mochoy/arduino-clone/README.md

# arduino-clone
Eagle schematic and board files for custom Arduino clones
