mochoy/arduino-clone/arduino clone v0.1/arduino clone schematics.pdf

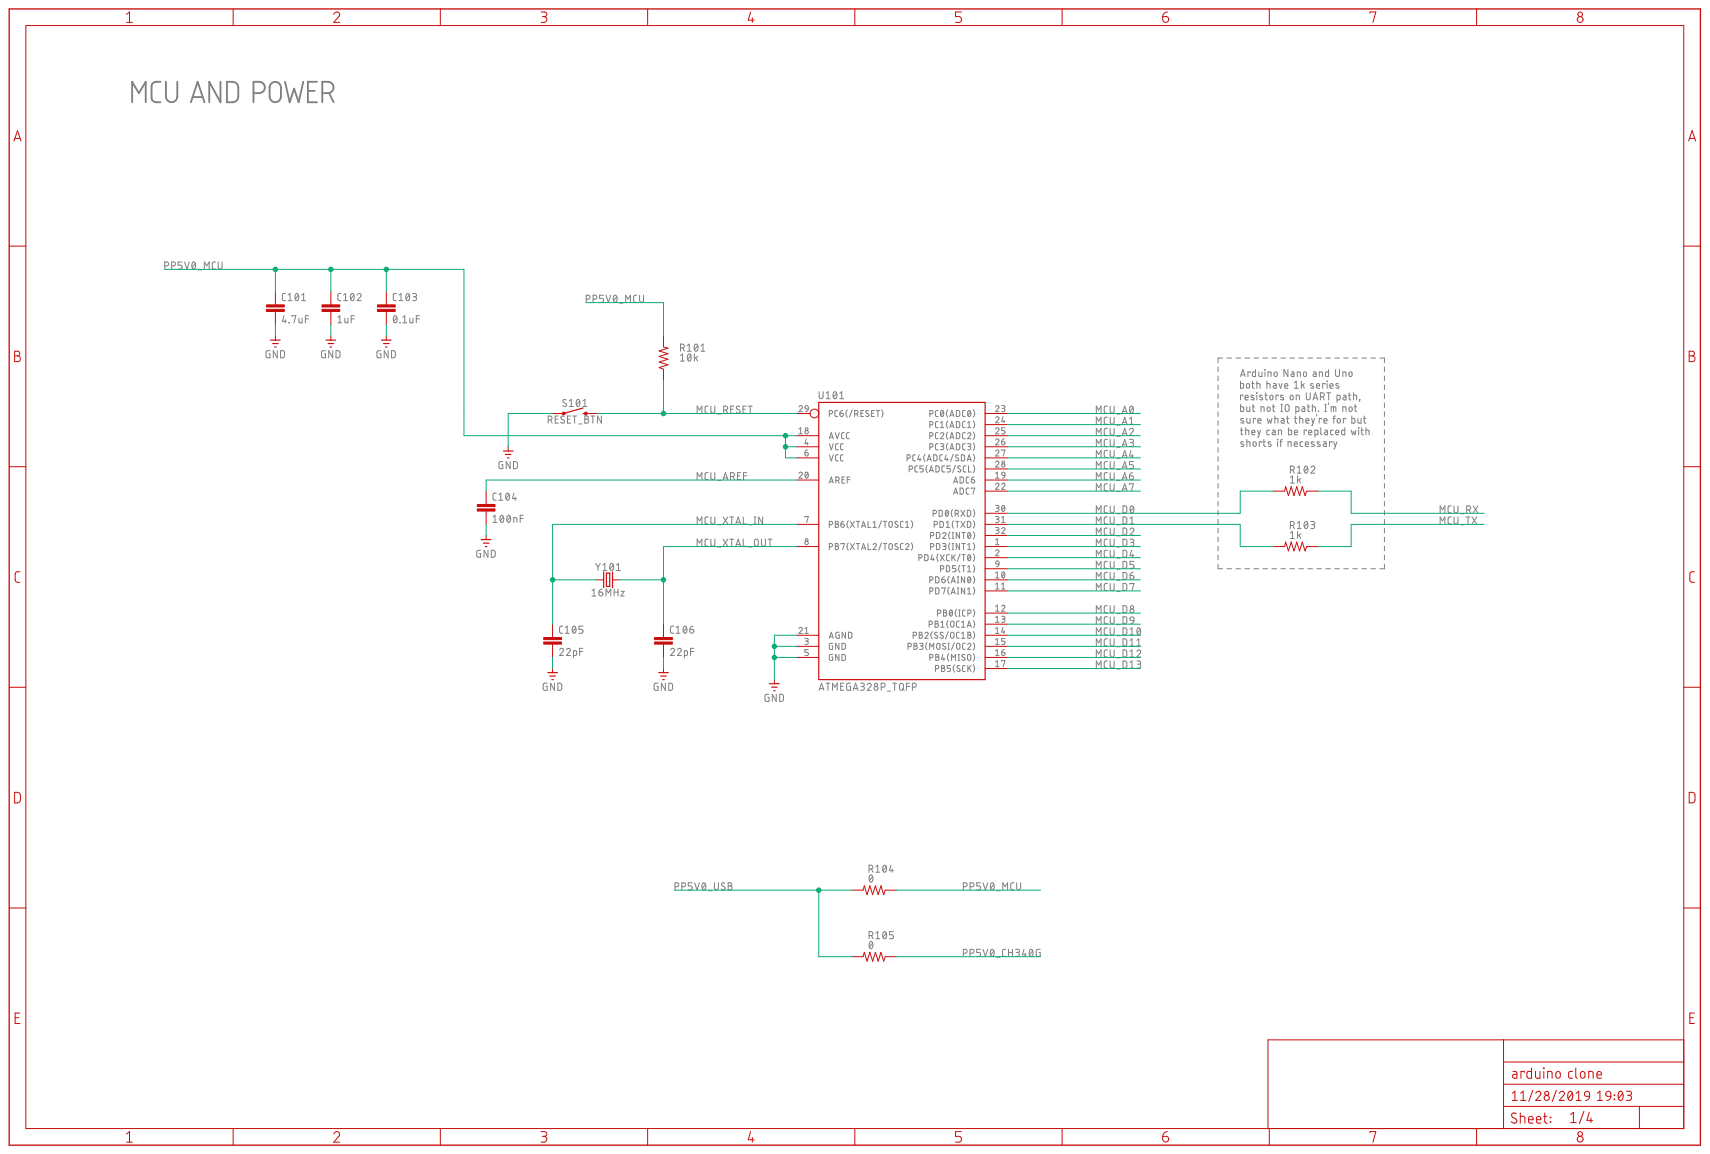
[picture p1: page 1]

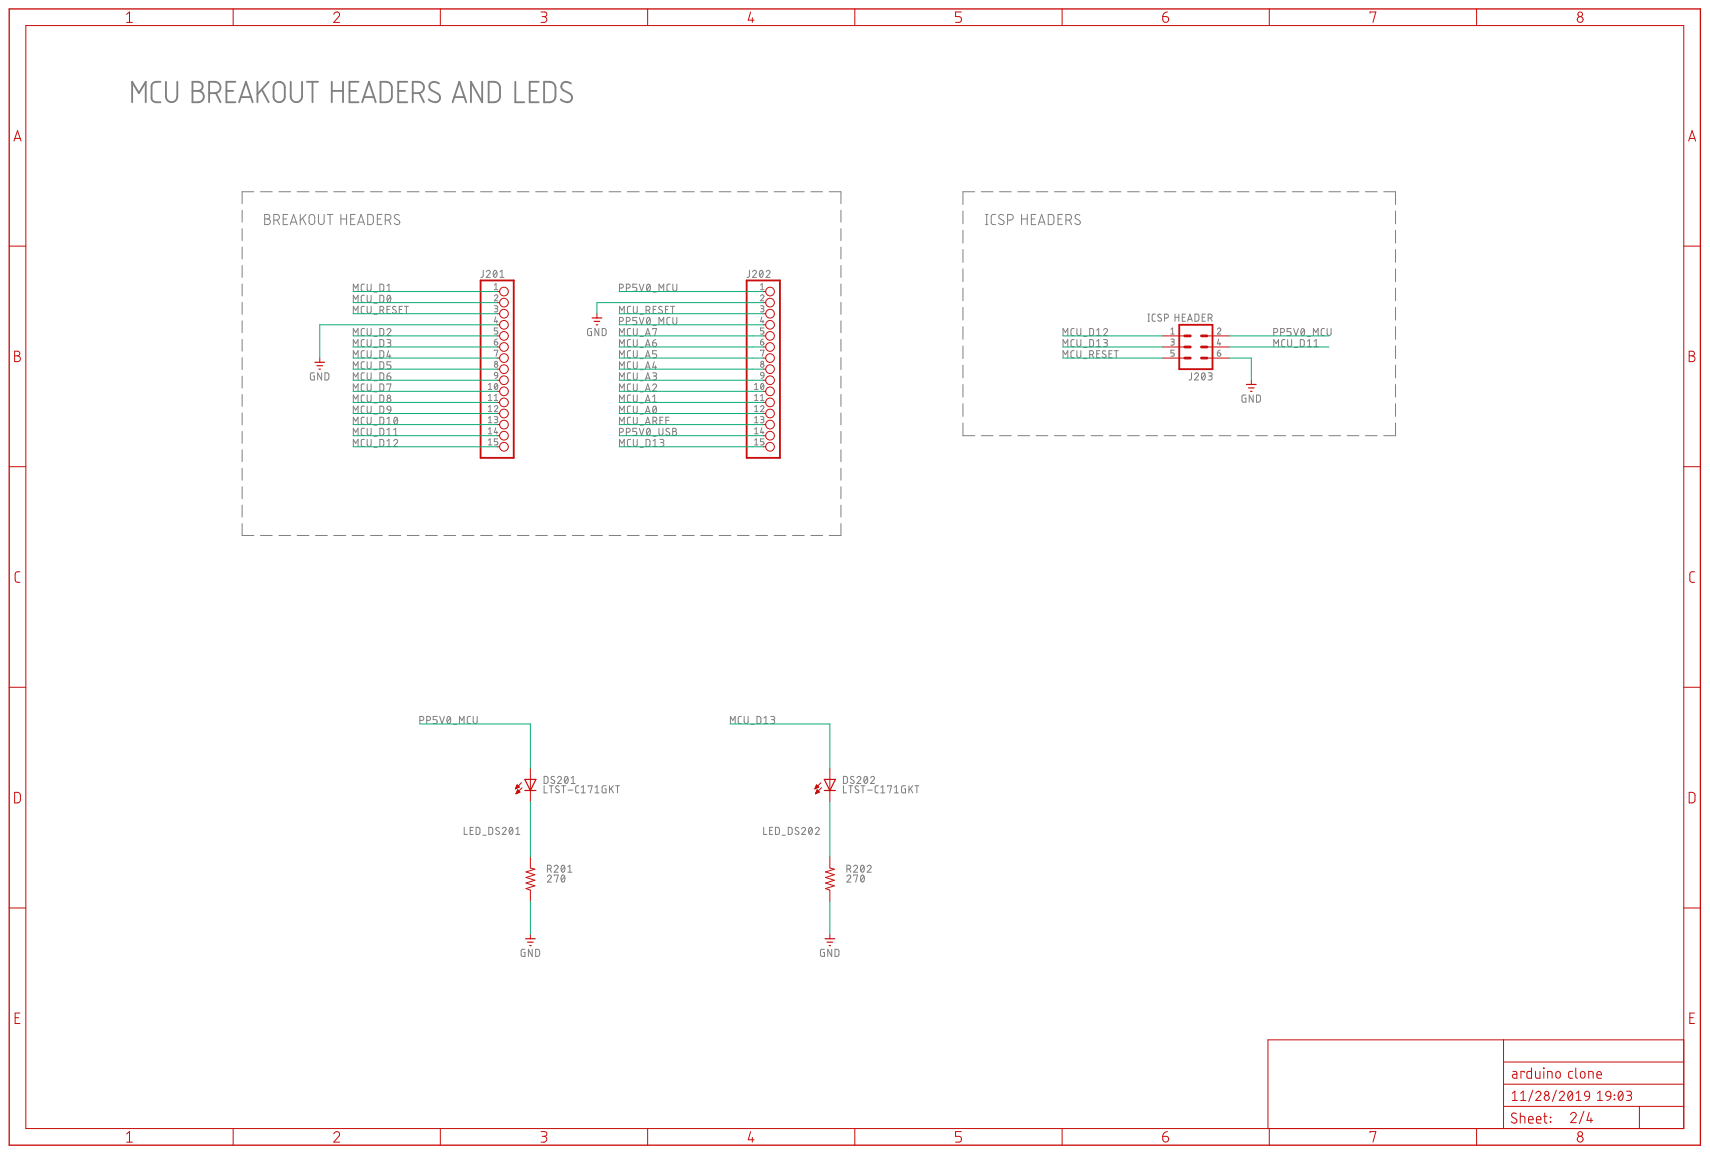
[picture p2: page 2]

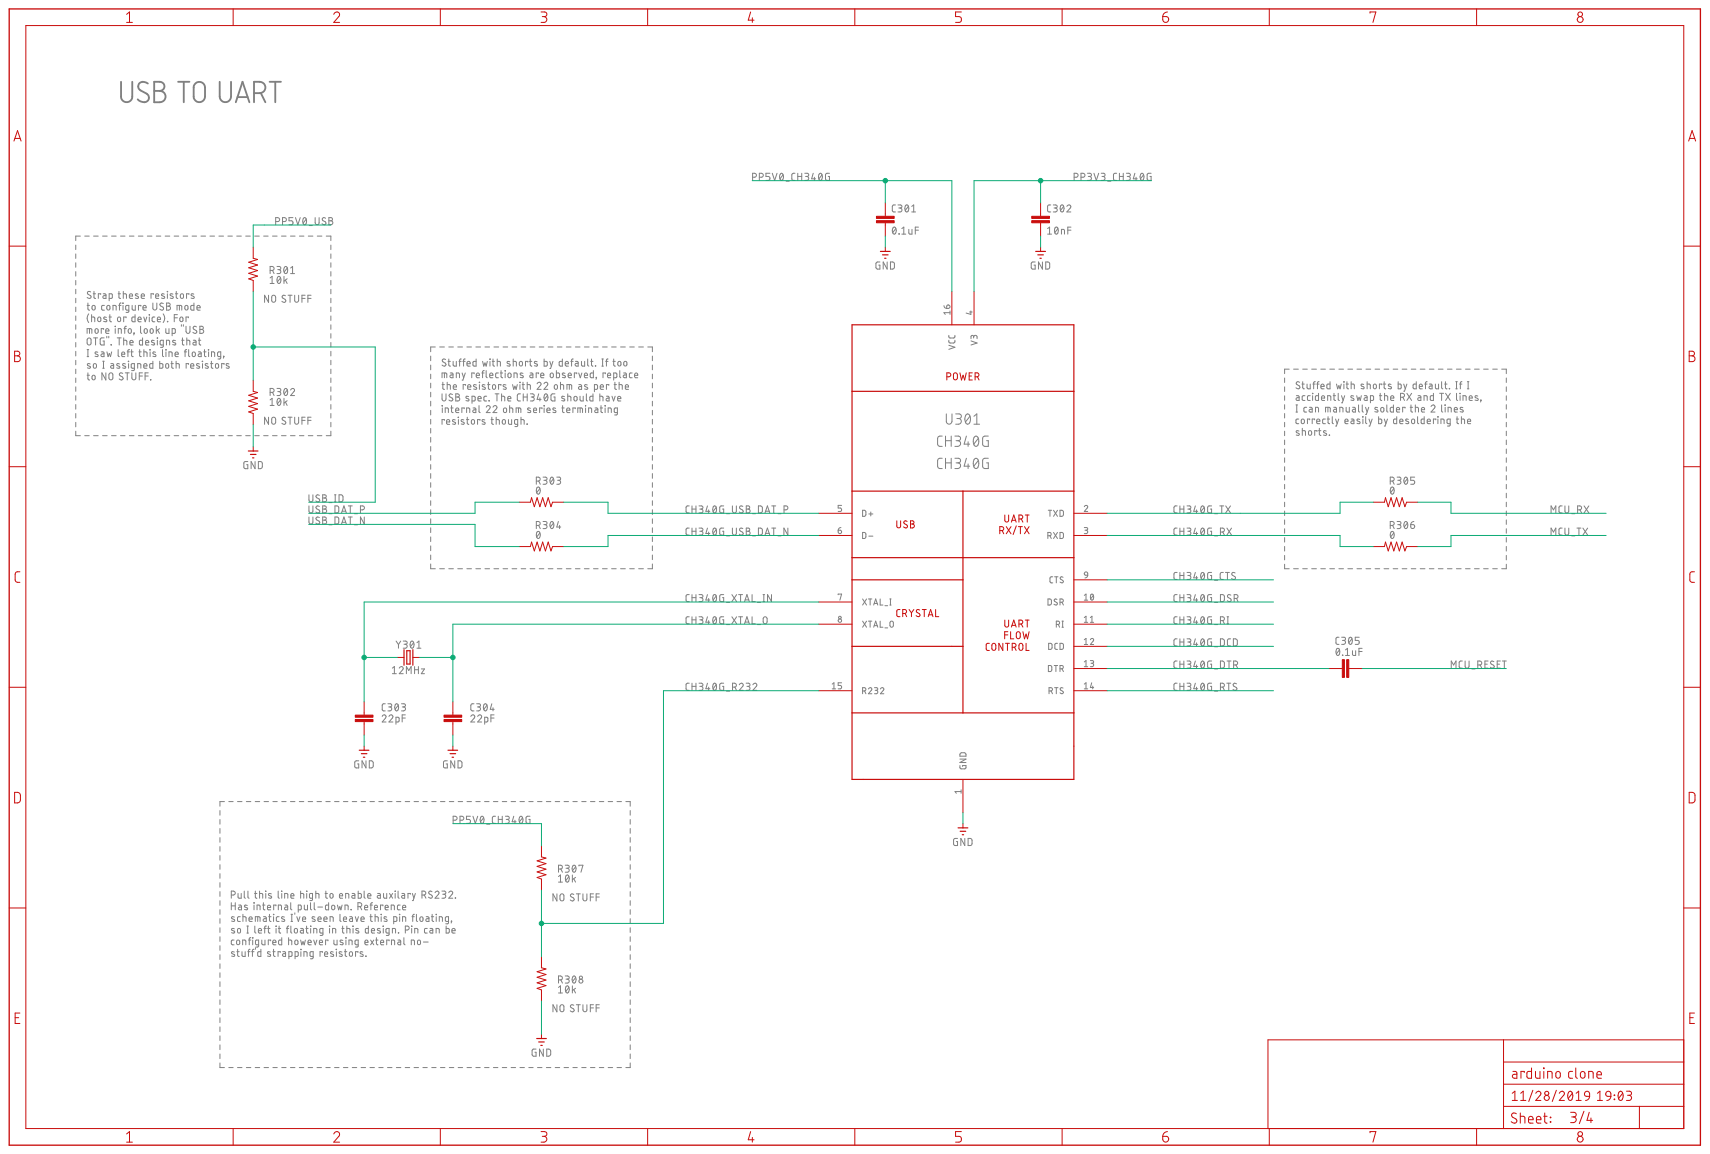
[picture p3: page 3]

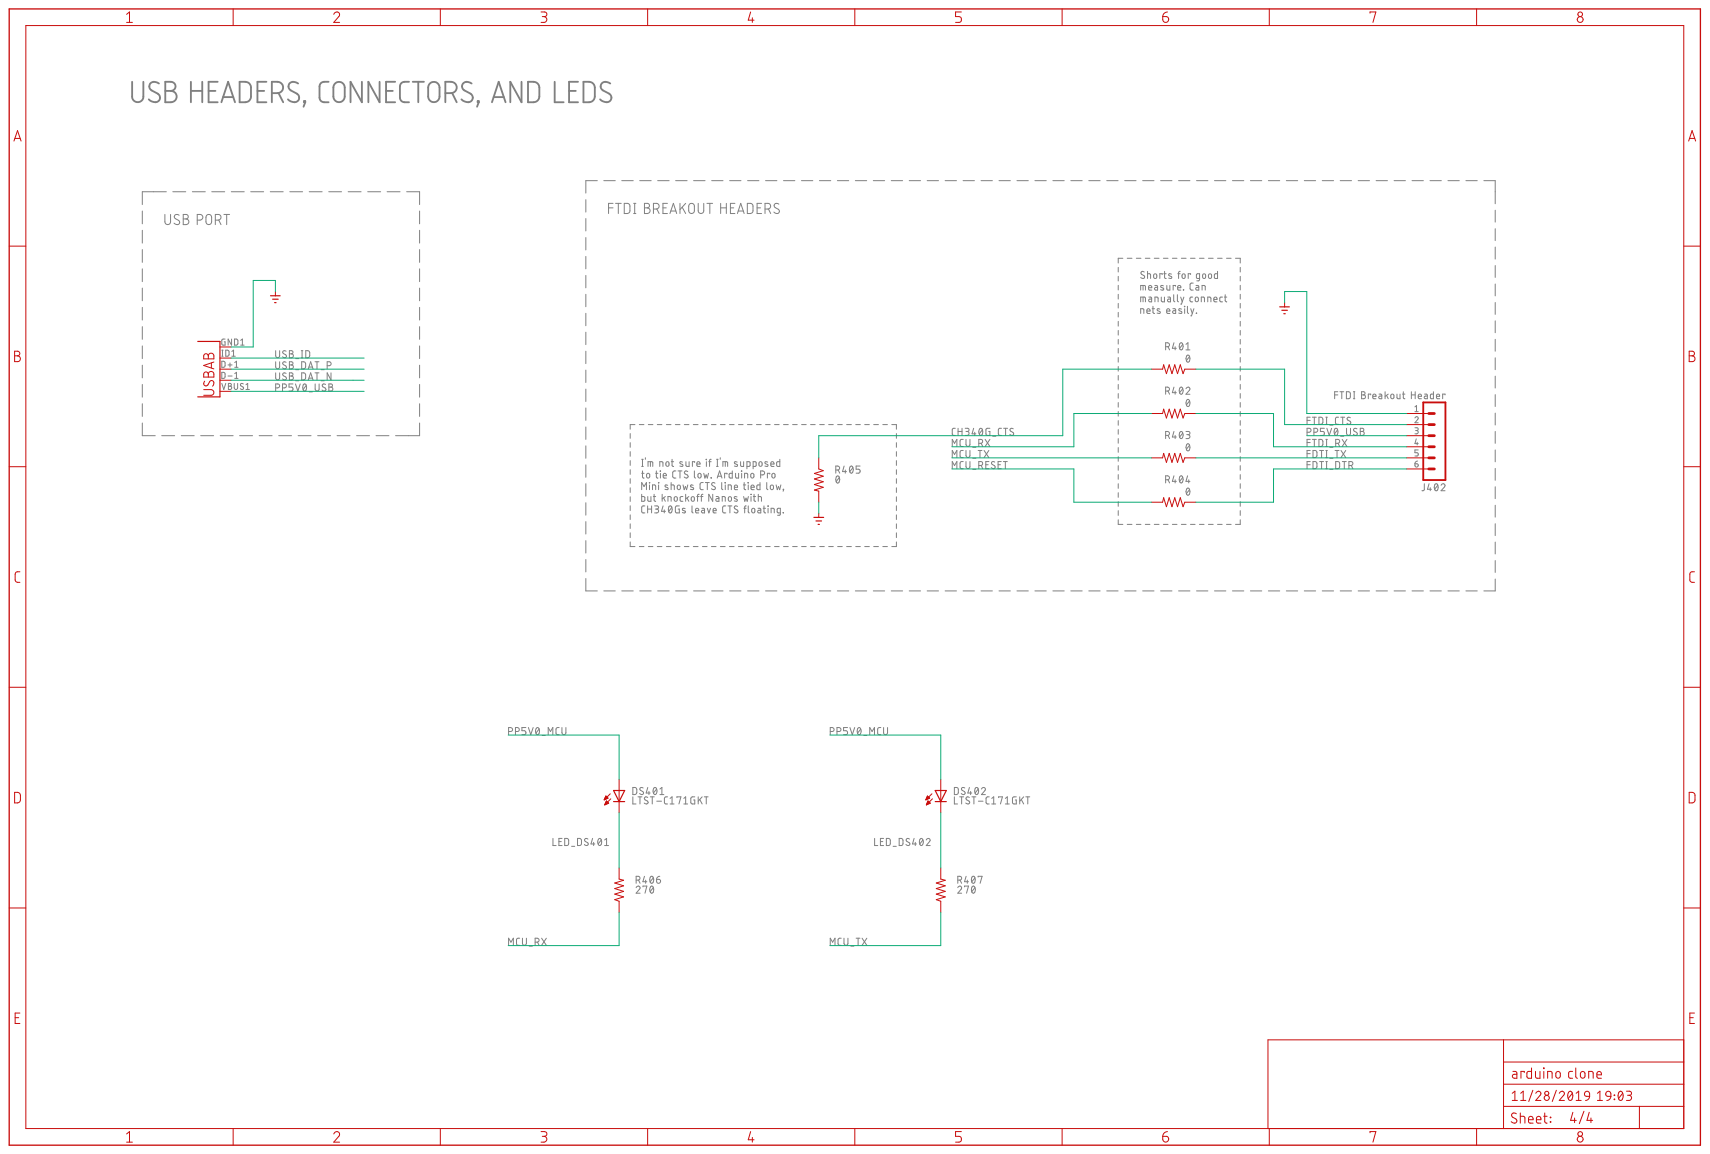
[picture p4: page 4]
