mochoy/arduino-clone/arduino clone v0.1/arduino clone.brd

## EAGLE design arduino clone v0.1/arduino clone.brd (2020-04-21)

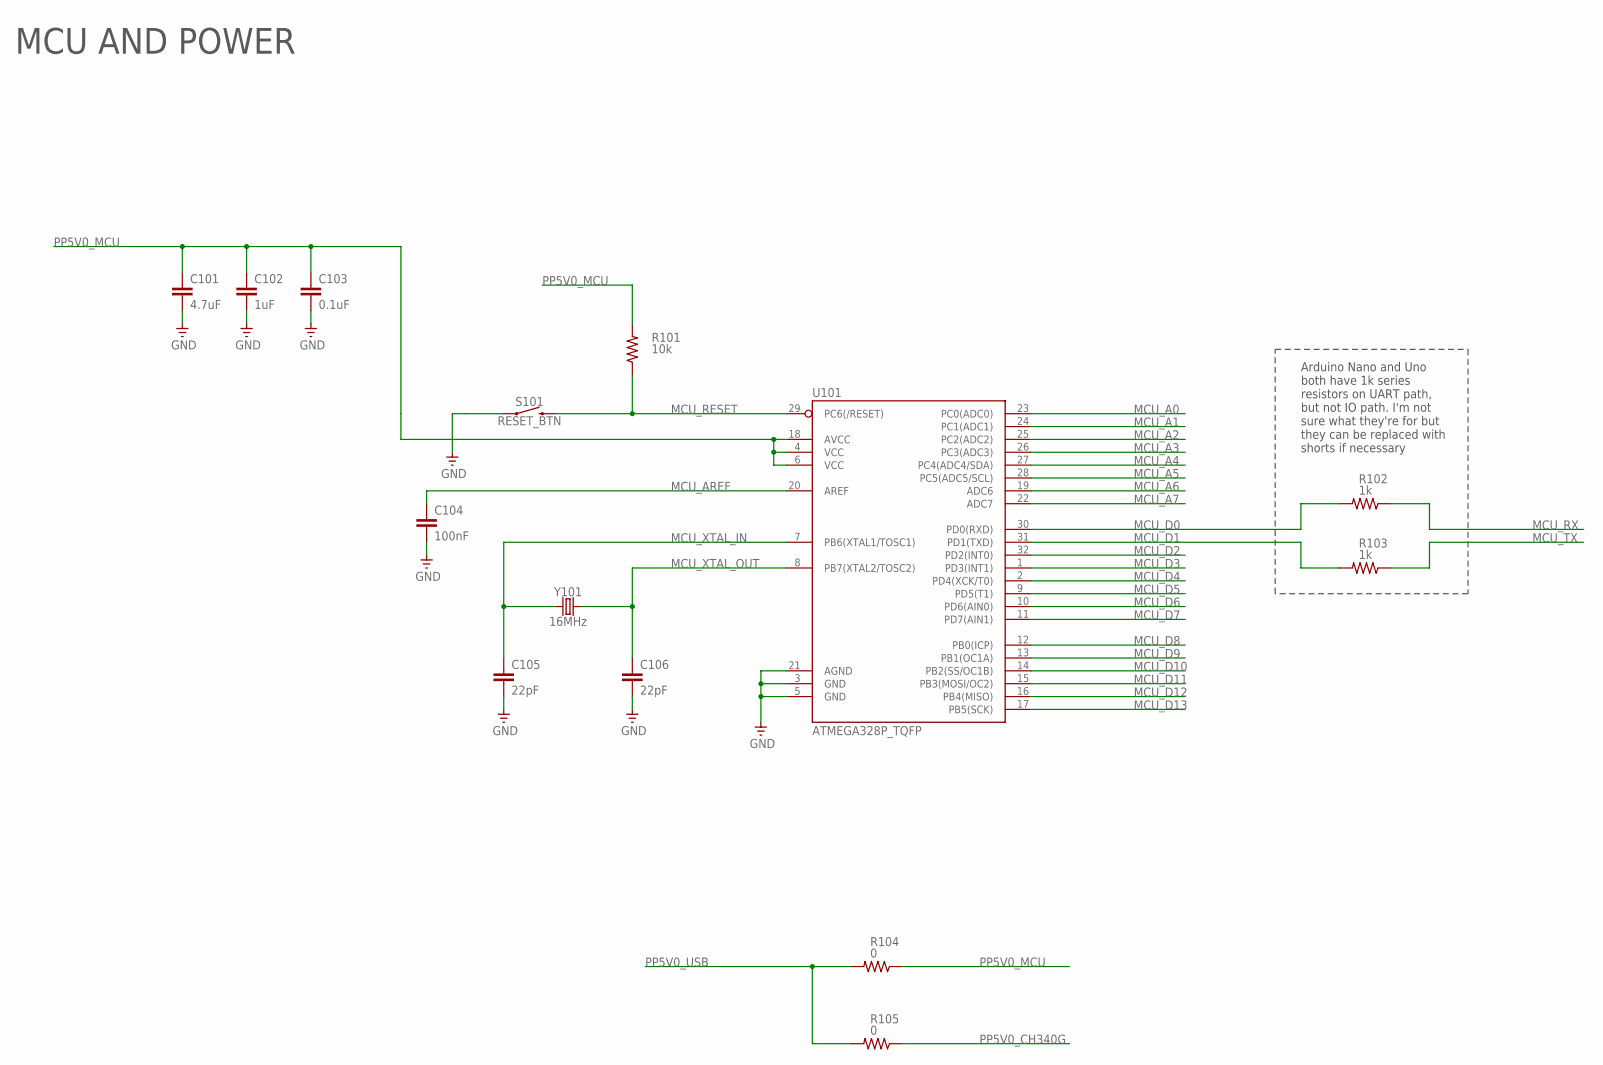
[picture p5: schematic arduino clone.sch, sheet 1]

Parts:
C101: 4.7uF; C0805
C102: 1uF; C0805
C103: 0.1uF; C0805
C104: 100nF; C0805
C105, C106: 22pF; C0805
R101: 10k; R0805
R102, R103: 1k; R0805
R104, R105: 0; R0805
S101: RESET_BTN; TACTILE_SWITCH_SMD_6.2MM_TALL
U101: ATMEGA328P_TQFP; TQFP32-08
Y101: 16MHz; CRYSTAL-SMD-5X3.2-4PAD

Connections:
GND: C101.2, C102.2, C103.2, C104.2, C105.2, C106.2, S101.A2 (1), U101.3 (GND), U101.5 (GND), U101.21 (AGND); also elsewhere on the board
MCU_A0: U101.23 (PC0(ADC0)); also elsewhere on the board
MCU_A1: U101.24 (PC1(ADC1)); also elsewhere on the board
MCU_A2: U101.25 (PC2(ADC2)); also elsewhere on the board
MCU_A3: U101.26 (PC3(ADC3)); also elsewhere on the board
MCU_A4: U101.27 (PC4(ADC4/SDA)); also elsewhere on the board
MCU_A5: U101.28 (PC5(ADC5/SCL)); also elsewhere on the board
MCU_A6: U101.19 (ADC6); also elsewhere on the board
MCU_A7: U101.22 (ADC7); also elsewhere on the board
MCU_AREF: C104.1, U101.20 (AREF); also elsewhere on the board
MCU_D0: R102.2, U101.30 (PD0(RXD)); also elsewhere on the board
MCU_D1: R103.2, U101.31 (PD1(TXD)); also elsewhere on the board
MCU_D2: U101.32 (PD2(INT0)); also elsewhere on the board
MCU_D3: U101.1 (PD3(INT1)); also elsewhere on the board
MCU_D4: U101.2 (PD4(XCK/T0)); also elsewhere on the board
MCU_D5: U101.9 (PD5(T1)); also elsewhere on the board
MCU_D6: U101.10 (PD6(AIN0)); also elsewhere on the board
MCU_D7: U101.11 (PD7(AIN1)); also elsewhere on the board
MCU_D8: U101.12 (PB0(ICP)); also elsewhere on the board
MCU_D9: U101.13 (PB1(OC1A)); also elsewhere on the board
MCU_D10: U101.14 (PB2(SS/OC1B)); also elsewhere on the board
MCU_D11: U101.15 (PB3(MOSI/OC2)); also elsewhere on the board
MCU_D12: U101.16 (PB4(MISO)); also elsewhere on the board
MCU_D13: U101.17 (PB5(SCK)); also elsewhere on the board
MCU_RESET: R101.1, S101.B2 (2), U101.29 (PC6(/RESET)); also elsewhere on the board
MCU_RX: R102.1; also elsewhere on the board
MCU_TX: R103.1; also elsewhere on the board
MCU_XTAL_IN: C105.1, U101.7 (PB6(XTAL1/TOSC1)), Y101.1
MCU_XTAL_OUT: C106.1, U101.8 (PB7(XTAL2/TOSC2)), Y101.3 (2)
PP5V0_CH340G: R105.1; also elsewhere on the board
PP5V0_MCU: C101.1, C102.1, C103.1, R101.2, R104.1, U101.4 (VCC), U101.6 (VCC), U101.18 (AVCC); also elsewhere on the board
PP5V0_USB: R104.2, R105.2; also elsewhere on the board

Notes on the sheet:
MCU AND POWER
Arduino Nano and Uno both have 1k series resistors on UART path, but not IO path. I'm not sure what they're for but they can be replaced with shorts if necessary

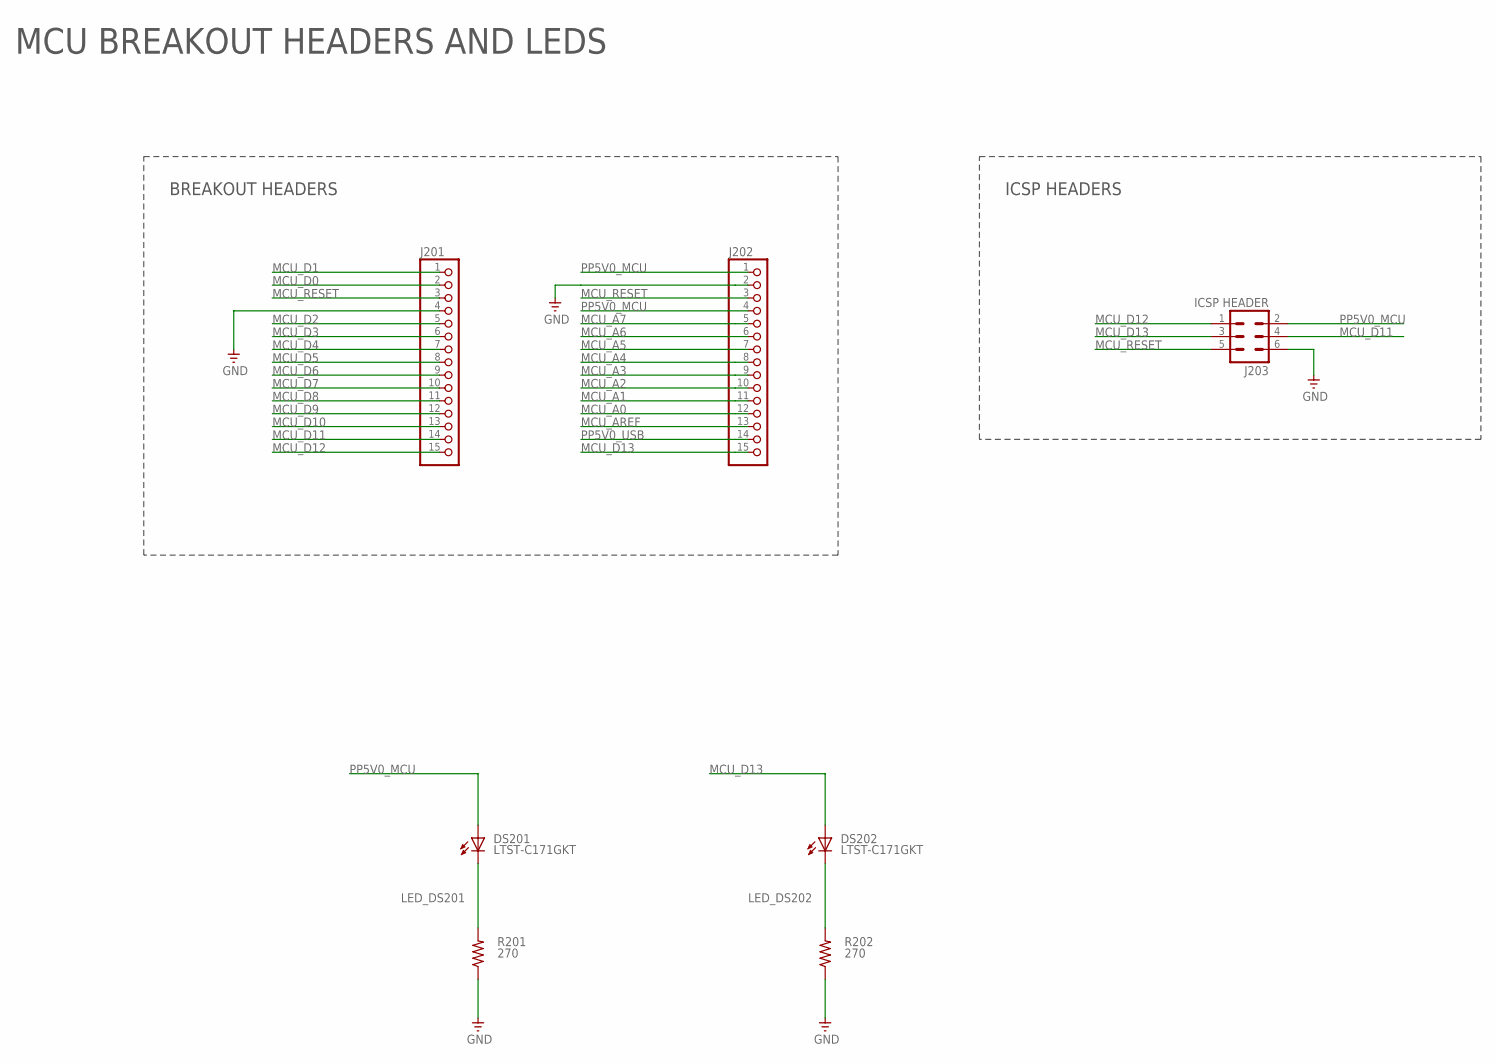
[picture p6: schematic arduino clone.sch, sheet 2]

Parts:
DS201, DS202: LTST-C171GKT; CHIPLED_0805
J201, J202: PINHD-1X15-CB; 1X15-CB
J203: ICSP HEADER; MA03-2
R201, R202: 270; M0805

Connections:
GND: J201.4, J202.2, J203.6, R201.1, R202.1; also elsewhere on the board
LED_DS201: DS201.C, R201.2
LED_DS202: DS202.C, R202.2
MCU_A0: J202.12; also elsewhere on the board
MCU_A1: J202.11; also elsewhere on the board
MCU_A2: J202.10; also elsewhere on the board
MCU_A3: J202.9; also elsewhere on the board
MCU_A4: J202.8; also elsewhere on the board
MCU_A5: J202.7; also elsewhere on the board
MCU_A6: J202.6; also elsewhere on the board
MCU_A7: J202.5; also elsewhere on the board
MCU_AREF: J202.13; also elsewhere on the board
MCU_D0: J201.2; also elsewhere on the board
MCU_D1: J201.1; also elsewhere on the board
MCU_D2: J201.5; also elsewhere on the board
MCU_D3: J201.6; also elsewhere on the board
MCU_D4: J201.7; also elsewhere on the board
MCU_D5: J201.8; also elsewhere on the board
MCU_D6: J201.9; also elsewhere on the board
MCU_D7: J201.10; also elsewhere on the board
MCU_D8: J201.11; also elsewhere on the board
MCU_D9: J201.12; also elsewhere on the board
MCU_D10: J201.13; also elsewhere on the board
MCU_D11: J201.14, J203.4; also elsewhere on the board
MCU_D12: J201.15, J203.1; also elsewhere on the board
MCU_D13: DS202.A, J202.15, J203.3; also elsewhere on the board
MCU_RESET: J201.3, J202.3, J203.5; also elsewhere on the board
PP5V0_MCU: DS201.A, J202.1, J202.4, J203.2; also elsewhere on the board
PP5V0_USB: J202.14; also elsewhere on the board

Notes on the sheet:
MCU BREAKOUT HEADERS AND LEDS
BREAKOUT HEADERS
ICSP HEADERS

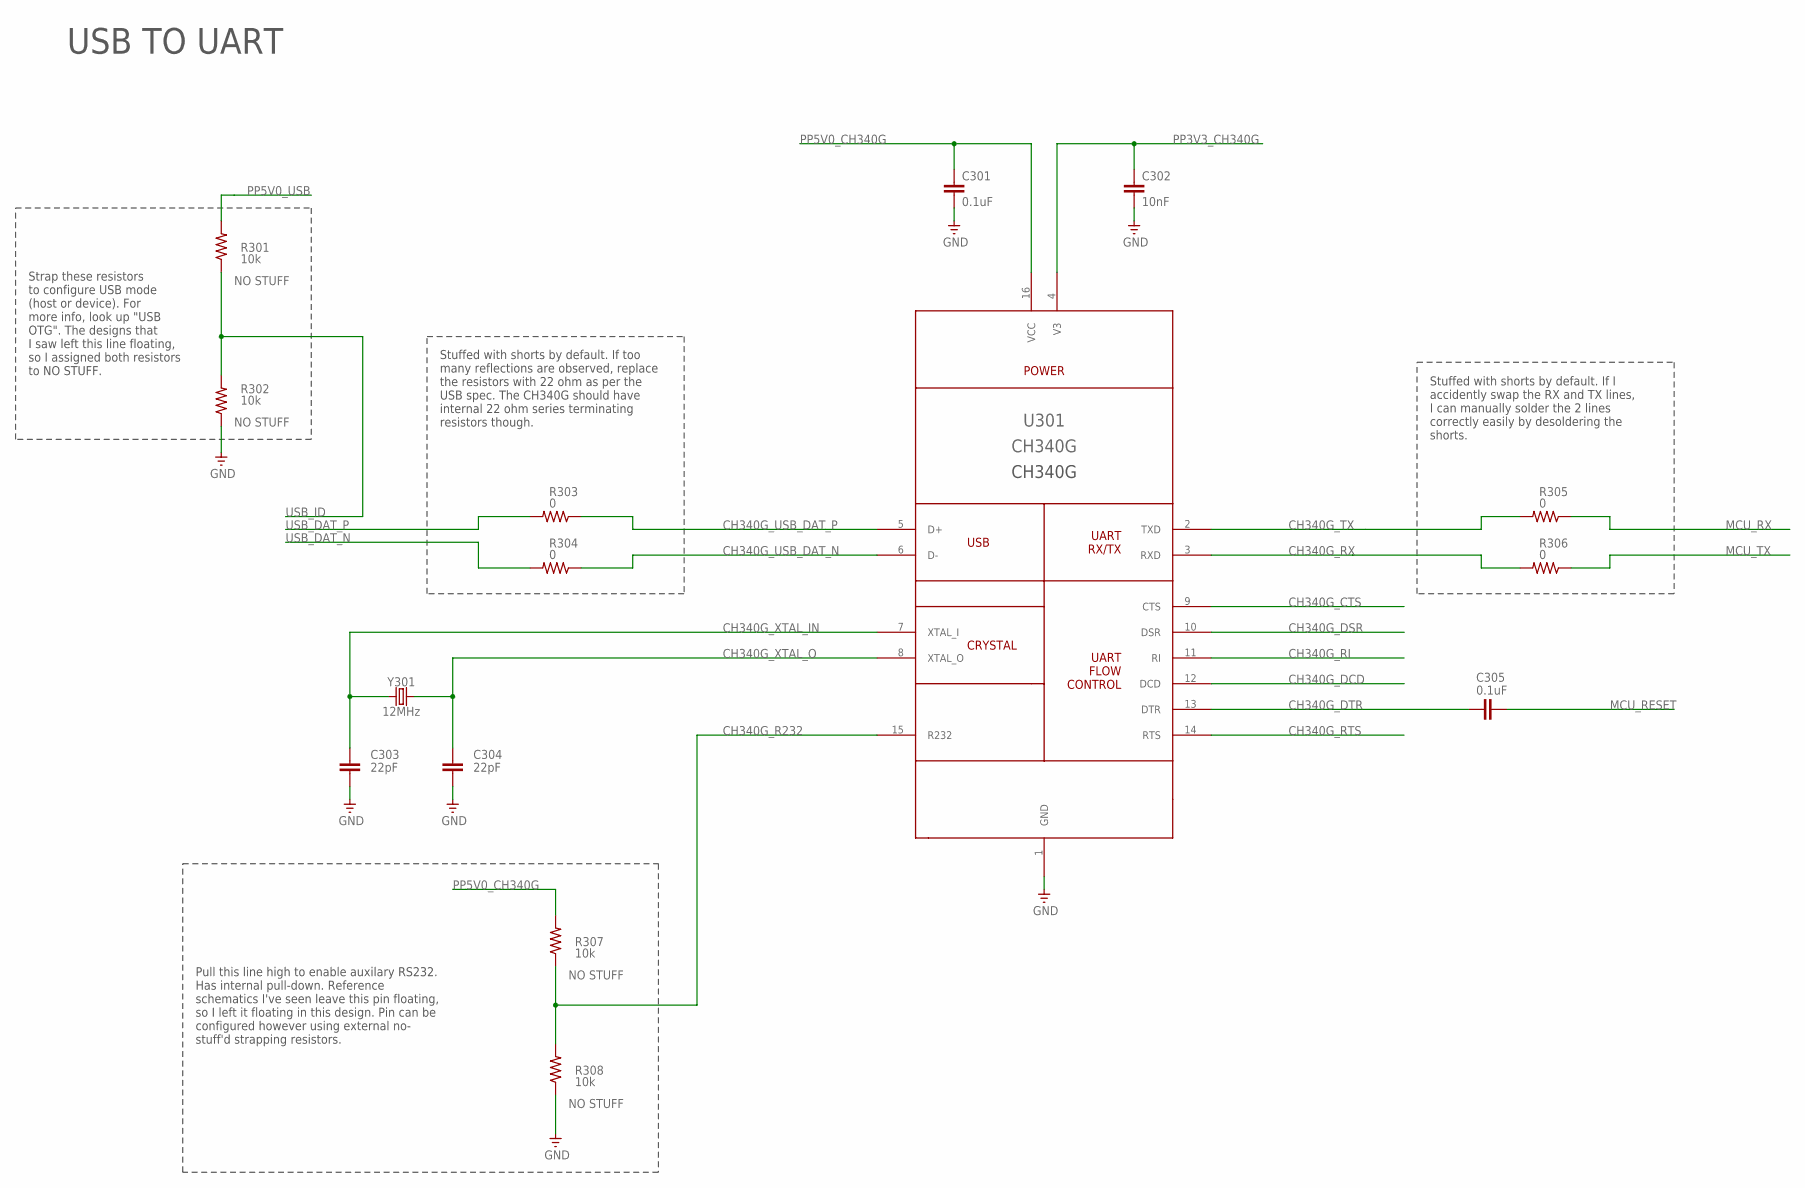
[picture p7: schematic arduino clone.sch, sheet 3]

Parts:
C301, C305: 0.1uF; C0805
C302: 10nF; C0805
C303, C304: 22pF; C0805
R301, R302, R307, R308: 10k; R0805
R303, R304, R305, R306: 0; R0805
U301: CH340G; SOIC16
Y301: 12MHz; CRYSTAL-SMD-5X3.2-4PAD

Connections:
CH340G_CTS: U301.9 (CTS); also elsewhere on the board
CH340G_DCD: U301.12 (DCD)
CH340G_DSR: U301.10 (DSR)
CH340G_DTR: C305.1, U301.13 (DTR)
CH340G_R232: R307.1, R308.2, U301.15 (R232)
CH340G_RI: U301.11 (RI)
CH340G_RTS: U301.14 (RTS)
CH340G_RX: R306.2, U301.3 (RXD)
CH340G_TX: R305.2, U301.2 (TXD)
CH340G_USB_DAT_N: R304.1, U301.6 (D-)
CH340G_USB_DAT_P: R303.1, U301.5 (D+)
CH340G_XTAL_IN: C303.1, U301.7 (XTAL_I), Y301.1
CH340G_XTAL_O: C304.1, U301.8 (XTAL_O), Y301.3 (2)
GND: C301.2, C302.2, C303.2, C304.2, R302.1, R308.1, U301.1 (GND); also elsewhere on the board
MCU_RESET: C305.2; also elsewhere on the board
MCU_RX: R305.1; also elsewhere on the board
MCU_TX: R306.1; also elsewhere on the board
PP3V3_CH340G: C302.1, U301.4 (V3)
PP5V0_CH340G: C301.1, R307.2, U301.16 (VCC); also elsewhere on the board
PP5V0_USB: R301.2; also elsewhere on the board
USB_DAT_N: R304.2; also elsewhere on the board
USB_DAT_P: R303.2; also elsewhere on the board
USB_ID: R301.1, R302.2; also elsewhere on the board

Notes on the sheet:
USB TO UART
Strap these resistors to configure USB mode (host or device). For more info, look up "USB OTG". The designs that I saw left this line floating, so I assigned both resistors to NO STUFF.
Stuffed with shorts by default. If too many reflections are observed, replace the resistors with 22 ohm as per the USB spec. The CH340G should have internal 22 ohm series terminating resistors though.
Stuffed with shorts by default. If I accidently swap the RX and TX lines, I can manually solder the 2 lines correctly easily by desoldering the shorts.
Pull this line high to enable auxilary RS232. Has internal pull-down. Reference schematics I've seen leave this pin floating, so I left it floating in this design. Pin can be configured however using external no- stuff'd strapping resistors.

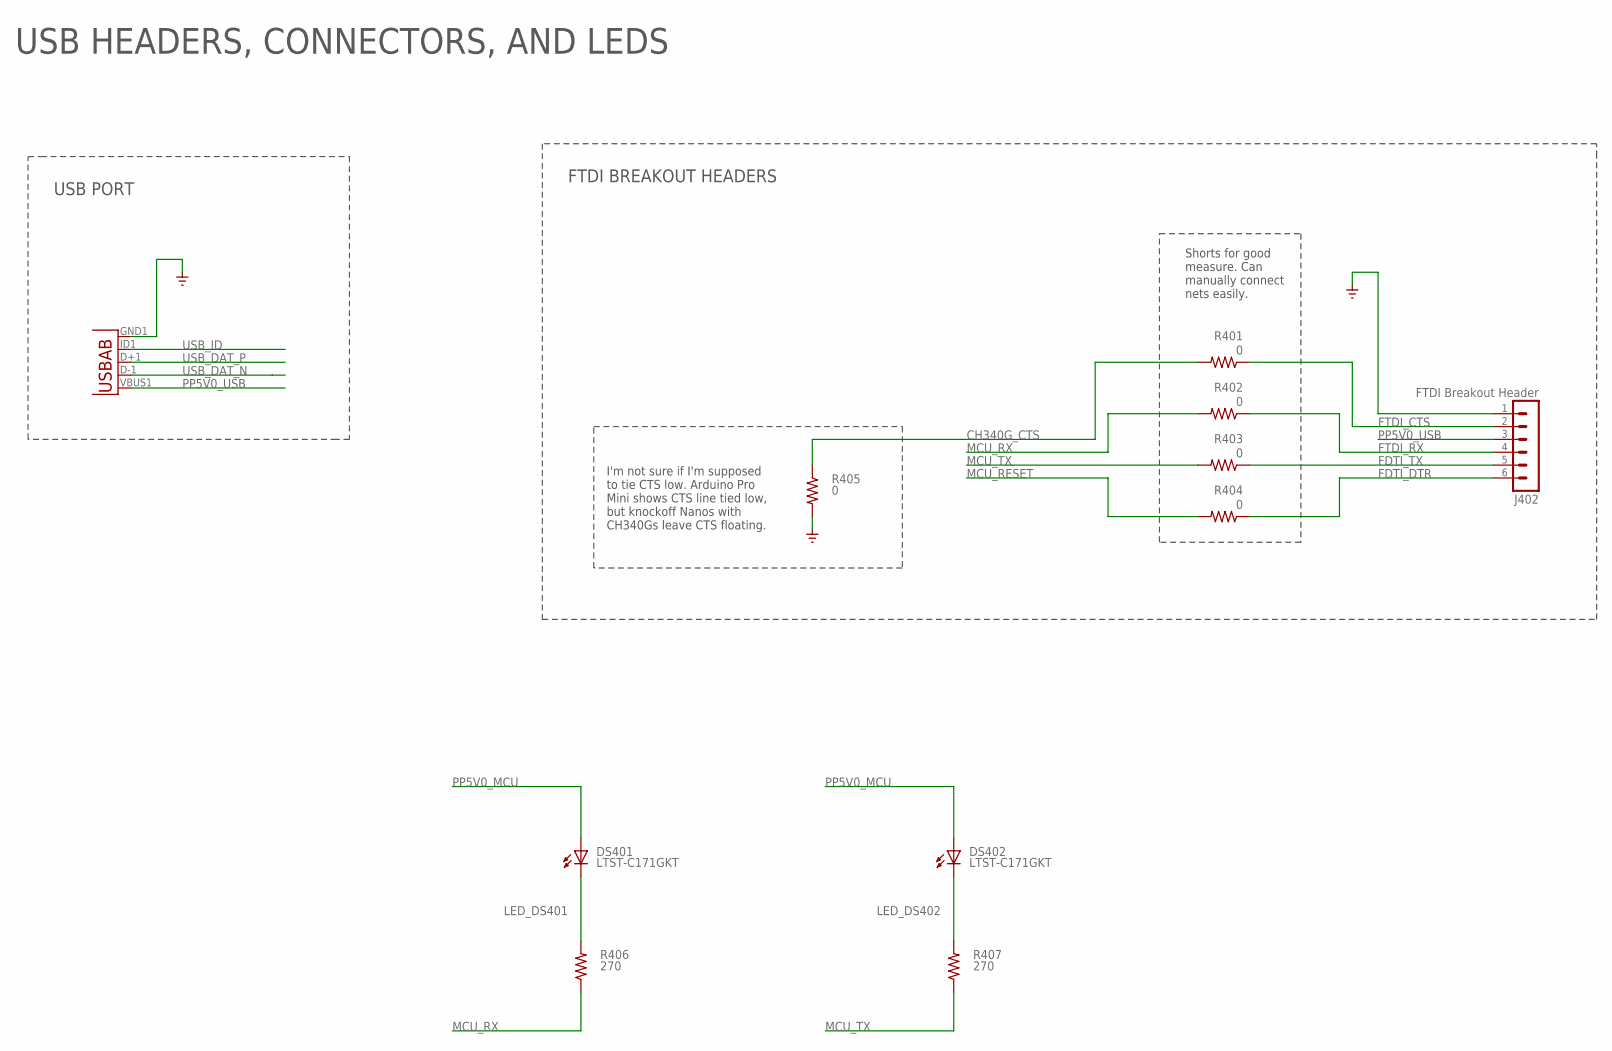
[picture p8: schematic arduino clone.sch, sheet 4]

Parts:
DS401, DS402: LTST-C171GKT; CHIPLED_0805
J401: USB-ABIN&OUT; USB-AB-MICRO-SMD-V03-IN&OUT
J402: FTDI Breakout Header; MA06-1
R401, R402, R403, R404, R405: 0; R0805
R406, R407: 270; M0805

Connections:
CH340G_CTS: R401.2, R405.1; also elsewhere on the board
FDTI_DTR: J402.6, R404.1
FDTI_TX: J402.5, R403.1
FTDI_CTS: J402.2, R401.1
FTDI_RX: J402.4, R402.1
GND: J401.GND1 (GND), J402.1, R405.2; also elsewhere on the board
LED_DS401: DS401.C, R406.2
LED_DS402: DS402.C, R407.2
MCU_RESET: R404.2; also elsewhere on the board
MCU_RX: R402.2, R406.1; also elsewhere on the board
MCU_TX: R403.2, R407.1; also elsewhere on the board
PP5V0_MCU: DS401.A, DS402.A; also elsewhere on the board
PP5V0_USB: J401.VBUS1 (VBUS), J402.3; also elsewhere on the board
USB_DAT_N: J401.D-1 (D-); also elsewhere on the board
USB_DAT_P: J401.D+1 (D+); also elsewhere on the board
USB_ID: J401.ID1 (USBID); also elsewhere on the board

Notes on the sheet:
USB HEADERS, CONNECTORS, AND LEDS
Shorts for good measure. Can manually connect nets easily.
I'm not sure if I'm supposed to tie CTS low. Arduino Pro Mini shows CTS line tied low, but knockoff Nanos with CH340Gs leave CTS floating.
USB PORT
FTDI BREAKOUT HEADERS

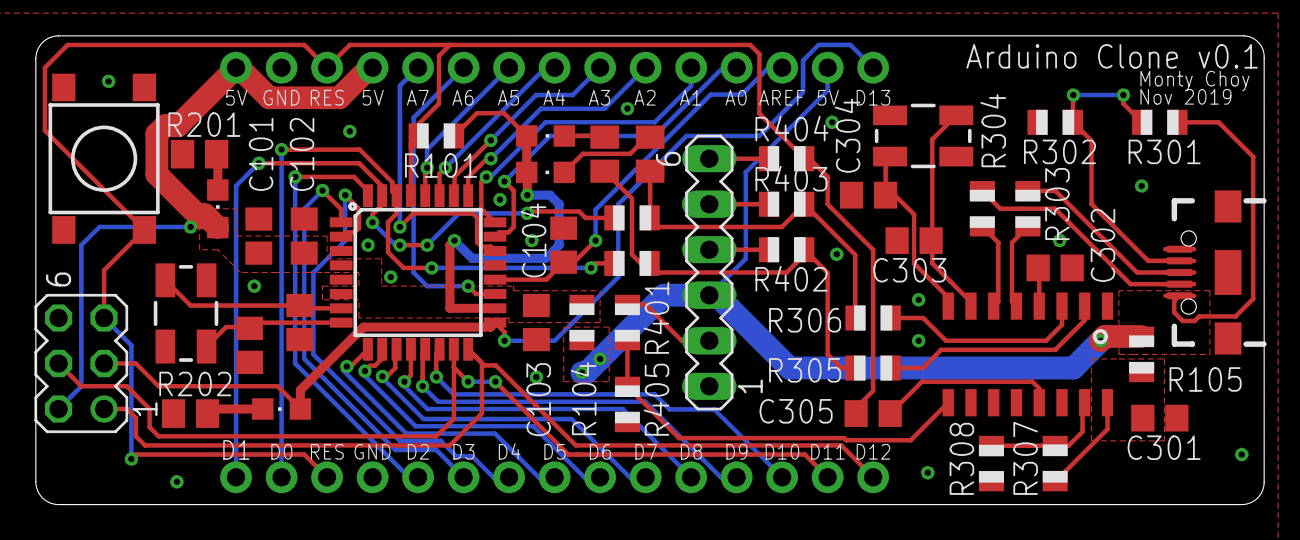
[picture p9: board arduino clone.brd from above]

Board: 2 copper layers, 68.6 x 26.2 mm, 47 parts (0 on the bottom side), 53 nets.
