mochoy/arduino-clone/(commit log)

2019-11-11 create project for arduino clone v0.1
2019-11-11 create schematic file for arduino clone
    [arduino clone.sch]
2019-11-11 add pages for MCU and CH340G
    [arduino clone.sch]
2019-11-12 add atmega328p and CH340G ICs
    [arduino clone.sch]
2019-11-12 add title to MCU and USB to UART pages
    [arduino clone.sch]
2019-11-14 connect VCC of MCU to PP5V0 rail
    [arduino clone.sch]
2019-11-15 connect gnd rails of MCU
    [arduino clone.sch]
2019-11-16 add decoupling caps to Arduino VCC rail
    [arduino clone.sch]
2019-11-16 add pullup to MCU reset
    [arduino clone.sch]
2019-11-16 add cap to aref pin
    [arduino clone.sch]
2019-11-16 add reset btn:
    [arduino clone.sch]
2019-11-18 add custom CH340G symbol
    [arduino clone.sch]
2019-11-18 add rail and rename CH340G
    [arduino clone.sch]
2019-11-19 add decoupling cap to 5V rail of CH340G
    [arduino clone.sch]
2019-11-19 connect gnd potential to CH340G
    [arduino clone.sch]
2019-11-19 add decoupling cap to PP3V3_CH340G rail
    [arduino clone.sch]
2019-11-19 add sparkfun micro USB port
    [arduino clone.sch]
2019-11-19 swap out USB for one used in Arduino Sparkfun pro mini
    [arduino clone.sch]
2019-11-19 connect gnd to usb port
    [arduino clone.sch]
2019-11-19 connect diff pair for USB
    [arduino clone.sch]
2019-11-19 add strapping resistors to ID of USB hub
    [arduino clone.sch]
2019-11-19 move strapping resistor ref des and value
    [arduino clone.sch]
2019-11-19 add power rail for USB
    [arduino clone.sch]
2019-11-19 add net name for USB ID pin
    [arduino clone.sch]
2019-11-19 add series termniation resistors for USB data diff pair
    [arduino clone.sch]
2019-11-19 add net names for diff pair on USB side
    [arduino clone.sch]
2019-11-19 add names for diff pair on CH340G side
    [arduino clone.sch]
2019-11-20 remove extra net on PP_USB rail
    [arduino clone.sch]
2019-11-20 add nostuff attribute to USB_ID net
    [arduino clone.sch]
2019-11-20 add descriptiont to strap USB_ID resistors
    [arduino clone.sch]
2019-11-20 move USB port and USB OTG strapping resistors
    [arduino clone.sch]
2019-11-21 add box around series termination resistors
    [arduino clone.sch]
2019-11-21 add note for series terminating resistors
    [arduino clone.sch]
2019-11-21 add RX and TX lines from CH340G
    [arduino clone.sch]
2019-11-21 add series resistors to UART lines
    [arduino clone.sch]
2019-11-21 add net names for AR UART lines on CH340G page
    [arduino clone.sch]
2019-11-21 connect AR_RX and TX to arduino
    [arduino clone.sch]
2019-11-22 add box around UART data resistors
    [arduino clone.sch]
2019-11-24 Add note for series resistors on RX and TX lines UART
    [arduino clone.sch]
2019-11-25 rename MCU nets to have 'mcu'
    [arduino clone.sch]
2019-11-25 add AC coupling cap on DTR line of CH340G
    [arduino clone.sch]
2019-11-25 disconnect USB nets from connector
    [arduino clone.sch]
2019-11-25 add signal nets to USB connector
    [arduino clone.sch]
2019-11-25 add named nets for CH350G UART flow control
    [arduino clone.sch]
2019-11-25 add FTDI breakout header
    [arduino clone.sch]
2019-11-25 add nets from FDTI headers to power and CTS
    [arduino clone.sch]
2019-11-25 add FTDI RX and TX lines
    [arduino clone.sch]
2019-11-25 add FTDI_DTR line
    [arduino clone.sch]
2019-11-25 connect MCU uart data lines to AR uart datalines
    [arduino clone.sch]
2019-11-25 add notes for FTDI breakout headers
    [arduino clone.sch]
2019-11-25 add note on CTS line
    [arduino clone.sch]
2019-11-25 update libs to fix R232 short pin
    [arduino clone.sch]
2019-11-25 add strapping resistors on CH340G_R323 pin
    [arduino clone.sch]
2019-11-25 ad notes to R232 strapping resistors
    [arduino clone.sch]
2019-11-25 add 22 pf caps for pierce oscillator
    [arduino clone.sch]
2019-11-25 add nets for crystal
    [arduino clone.sch]
2019-11-25 add and name crystal oscillator
    [arduino clone.sch]
2019-11-25 move RS232 strappig network higher up
    [arduino clone.sch]
2019-11-25 replace crystal with 12MHz as per CH340G spec
    [arduino clone.sch]
2019-11-25 rename caps on 5V0 MCU rail to apple naming convention
    [arduino clone.sch]
2019-11-25 rename rest of MCU components to apple naming convnetnion:
    [arduino clone.sch]
2019-11-25 add back RS232 strapping network that I accidently deleted
    [arduino clone.sch]
2019-11-25 update library to have new XTAL pin names
    [arduino clone.sch]
2019-11-25 update oscillator net names to XTA
    [arduino clone.sch]
2019-11-25 add pierce oscillator to MCU
    [arduino clone.sch]
2019-11-25 add net names for MCU XTAL
    [arduino clone.sch]
2019-11-25 move MCU nets out to give space for net names
    [arduino clone.sch]
2019-11-25 move XTAL and AREF decoupling components out to give space for net names
    [arduino clone.sch]
2019-11-26 add MCU analog port nets
    [arduino clone.sch]
2019-11-26 add 1k resistors on MCU UART lines
    [arduino clone.sch]
2019-11-26 connect UART lines to MCU_[UART]_R
    [arduino clone.sch]
2019-11-26 diverge FTDI header nets
    [arduino clone.sch]
2019-11-26 re-arragne resistor and note for CH340G_CTS
    [arduino clone.sch]
2019-11-26 rotate ref des and value for CTS strapping resistor
    [arduino clone.sch]
2019-11-26 add notes on MCU UART lines
    [arduino clone.sch]
2019-11-26 rename MCU pins to MCU_Dx and MCU uart lines
    [arduino clone.sch]
2019-11-26 rename all MCU_TX_R to MCU_TX
    [arduino clone.sch]
2019-11-26 add nets for port D pins
    [arduino clone.sch]
2019-11-26 add nets for pins on port B
    [arduino clone.sch]
2019-11-26 change a decoupling cap on 5V_MCU rail to 0.1uF
    [arduino clone.sch]
2019-11-26 center MCU stuff on page
    [arduino clone.sch]
2019-11-26 add page for MCU Breakout headers
    [arduino clone.sch]
2019-11-26 add page for USB connectors, headers, and LEDs
    rename MCU headers page to also include LEDs
    [arduino clone.sch]
2019-11-26 move USB port to page 4
    [arduino clone.sch]
2019-11-26 move FTDI breakout header to page 3
    [arduino clone.sch]
2019-11-26 center CH340G on page
    [arduino clone.sch]
2019-11-26 Re-add netnames on page 4
    [arduino clone.sch]
2019-11-26 rename everything on page 3 to have '3' prefix
    [arduino clone.sch]
2019-11-26 add boxes and labels for USB port and FTDI breakout headers
    [arduino clone.sch]
2019-11-26 page 1 also dedicated to power
    [arduino clone.sch]
2019-11-26 move MCU stuff up to give space for power stuff below on same page
    [arduino clone.sch]
2019-11-26 add resistors for power stuff
    [arduino clone.sch]
2019-11-26 add ICSP header
    [arduino clone.sch]
2019-11-26 add breakout headers
    [arduino clone.sch]
2019-11-26 connect left breakout header
    [arduino clone.sch]
2019-11-26 connect breakout headers for right breakout headers
    [arduino clone.sch]
2019-11-26 add and label box around breakout headers
    [arduino clone.sch]
2019-11-26 connect up ICSP headers
    [arduino clone.sch]
2019-11-26 add box and label for ICSP headers
    [arduino clone.sch]
2019-11-26 create board from schemtaic
    [arduino clone.brd]
2019-11-26 add LED on 5V MCU rail
    [arduino clone.brd, arduino clone.sch]
2019-11-26 add LED on pin 13
    [arduino clone.brd, arduino clone.sch]
2019-11-26 D13 LED sources from D13
    [arduino clone.brd, arduino clone.sch]
2019-11-26 add debug LEDs for UART data lines
    [arduino clone.brd, arduino clone.sch]
2019-11-26 place headers, ICs, and USB port
    [arduino clone.brd, arduino clone.sch]
2019-11-26 rename neg USB diff pair with 'N' prefix
    [arduino clone.brd, arduino clone.sch]
2019-11-27 define netclass for USB data diff paris
    [arduino clone.brd, arduino clone.sch]
2019-11-27 rename USB diff pairs so they're recognized by eagle
    [arduino clone.brd, arduino clone.sch]
2019-11-27 assign net class to USB diff pair
    [arduino clone.brd, arduino clone.sch]
2019-11-27 rename diff pair on USB side so eagle can detect it
    [arduino clone.brd, arduino clone.sch]
2019-11-27 extend left side traces on CH340G to give space for longer USB data names
    [arduino clone.sch]
2019-11-27 USB diff pair net class now 10mil trace width
    [arduino clone.brd, arduino clone.sch]
2019-11-27 assign USB diff pair on CH340G side to USB diff pair net class
    [arduino clone.brd, arduino clone.sch]
2019-11-27 route USB diff pair on CH340G side
    [arduino clone.brd]
2019-11-27 route USB diff pair on USB port side
    [arduino clone.brd]
2019-11-27 route traces for crystal CH340G
    [arduino clone.brd]
2019-11-27 move CH340G crystal capacitor as suggested in microchip document
    [arduino clone.brd]
2019-11-27 move CH340G crystal lines away from USB dat lines
    [arduino clone.brd]
2019-11-27 place and route MCU oscillator
    [arduino clone.brd]
2019-11-27 move crystal and caps closer to CH340G
    [arduino clone.brd]
2019-11-27 move USB diff pair routing to give space for 3.3V docoupling cap
    [arduino clone.brd]
2019-11-27 place and route USB_ID strapping resistors
    [arduino clone.brd]
2019-11-27 place and route TX and RX from CH340G
    [arduino clone.brd]
2019-11-27 place and route resistors between CH340G and FTDI headers
    [arduino clone.brd]
2019-11-27 place and route UART debug LEDs
    [arduino clone.brd]
2019-11-27 place decoupling caps for MCU power
    [arduino clone.brd]
2019-11-27 add shape for PP5V0_MCU
    [arduino clone.brd]
2019-11-27 refine PP5V0_MCU shape
    [arduino clone.brd]
2019-11-27 extend PP5V0_MCU shape to hit another nearby pin
    [arduino clone.brd]
2019-11-27 place and route decoupling cap C104
    [arduino clone.brd]
2019-11-27 add top gnd place
    [arduino clone.brd]
2019-11-27 route UART RX and TX lines to MCU
    [arduino clone.brd]
2019-11-27 place and route power indicator LED
    [arduino clone.brd]
2019-11-27 place CH340G power series reisistor
    [arduino clone.brd]
2019-11-27 add shape for PP5V0_USB
    [arduino clone.brd]
2019-11-27 add shape for PP5V0_CH340G
    [arduino clone.brd]
2019-11-27 add trace from FTDI header to resistor
    [arduino clone.brd]
2019-11-28 place and route D13 LED
    [arduino clone.brd, arduino clone.sch]
2019-11-28 place R104 and extend PP5V)_USB shape to hit it
    [arduino clone.brd]
2019-11-28 rotate C104 180 deg to give space to other stuff
    [arduino clone.brd]
2019-11-28 move R104 to right of MCU, close off PP5V0_MCU plane to left of MCU
    [arduino clone.brd]
2019-11-28 move series UART resistors down
    [arduino clone.brd]
2019-11-28 place and route UART LEDs
    [arduino clone.brd]
2019-11-28 smash UART LED resistor ref des
    [arduino clone.brd]
2019-11-28 move UART resistors and LEDs up to give space for MCU power decouoling
    [arduino clone.brd]
2019-11-28 move C103 and R104 and MCU power shape over to left
    [arduino clone.brd]
2019-11-28 move and route FTDI CTS resistors
    [arduino clone.brd]
2019-11-28 route PP5V0_USB from MCU to FTDI header
    [arduino clone.brd]
2019-11-28 move decoupling caps on left side of MCU closer to MCU
    [arduino clone.brd]
2019-11-28 expand PP5V0_MCU shape to traverse accross IC and hit moth sides of MCU
    [arduino clone.brd]
2019-11-28 move and redo PP5V0_MCU shape on left of MCU
    [arduino clone.brd]
2019-11-28 move and reroute R201
    [arduino clone.brd]
2019-11-28 route trace from D13 to LED
    [arduino clone.brd]
2019-11-28 redo CH340G_R232 trace to set trace between R308 and R307 to that net
    [arduino clone.brd, arduino clone.sch]
2019-11-28 move and re-route R201
    [arduino clone.brd]
2019-11-28 route SPI lines to ICSP headers
    [arduino clone.brd]
2019-11-28 ICSP header now connects power to PP5V0_MCU
    [arduino clone.brd, arduino clone.sch]
2019-11-28 route PP5V0_MCU to ICSP header
    [arduino clone.brd]
2019-11-28 place and route R101
    [arduino clone.brd]
2019-11-28 route PP5V0_MCU to UART LEDs
    [arduino clone.brd]
2019-11-28 route analog pins 2-5
    [arduino clone.brd]
2019-11-28 connect rest of analog pins
    [arduino clone.brd]
2019-11-28 palce and route C305
    [arduino clone.brd]
2019-11-28 route reset signals
    [arduino clone.brd]
2019-11-28 route MCU_AREF
    [arduino clone.brd]
2019-11-28 route and place R308 and R307
    [arduino clone.brd]
2019-11-28 add PP5V0_USB trace from USB port to FTDI header
    [arduino clone.brd]
2019-11-28 add D13 trace from MCU to header
    [arduino clone.brd]
2019-11-28 add thicker traces for PP5V0_USB to headers
    [arduino clone.brd]
2019-11-28 headers connect to PP5V0_MCU instead of PP5V0_USB
    [arduino clone.brd, arduino clone.sch]
2019-11-28 route PP5V0_MCU to headers
    [arduino clone.brd]
2019-11-28 route D0,1,3
    [arduino clone.brd]
2019-11-28 route D3 and D4
    [arduino clone.brd]
2019-11-28 reroute D2 and D3
    [arduino clone.brd]
2019-11-28 route rest of Digital pins
    [arduino clone.brd]
2019-11-28 route PP5V0_USB to pullup R301
    [arduino clone.brd]
2019-11-28 approve DRCs with USB port
    [arduino clone.brd]
2019-11-29 move around traces to shrink board outline
    [arduino clone.brd]
2019-11-29 round corners
    [arduino clone.brd]
2019-11-29 add gnd plane on bottom
    [arduino clone.brd]
2019-11-29 add gnd vias so gnd hits everything
    [arduino clone.brd]
2019-11-29 add shape for PP5V0_USB to MCU
    [arduino clone.brd]
2019-11-29 remove wire stubs
    [arduino clone.brd]
2019-11-29 add more gnd vias to push gnd plane out
    [arduino clone.brd]
2019-11-29 move ref des of R301 and R302 down to give space for txt aboce
    [arduino clone.brd]
2019-11-29 add project title, name, and date
    [arduino clone.brd]
2019-11-29 add txt for bottom row of headers
    [arduino clone.brd]
2019-11-29 add text to top headers
    [arduino clone.brd]
2019-11-29 move gnd via so it doesn't block txt
    [arduino clone.brd]
2019-11-29 add 50 mil 5V trace
    [arduino clone.brd]
2019-11-29 expand 5V power plane that runs under MCU IC
    [arduino clone.brd]
2019-11-29 move R301 pullup trace for better gnd path from USB port
    [arduino clone.brd]
2019-11-29 re-route USB_ID trace for better gnd coverage
    [arduino clone.brd]
2019-11-29 add more random gnd vias
    [arduino clone.brd]
2019-11-29 generate gerbers for v0.1
2020-01-02 generate pdf schematics
2020-04-21 regenerate gerbers that include drill file
    [arduino clone.brd, arduino clone.csv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]
